Codegulasch/printdock-station/case/plate.stl

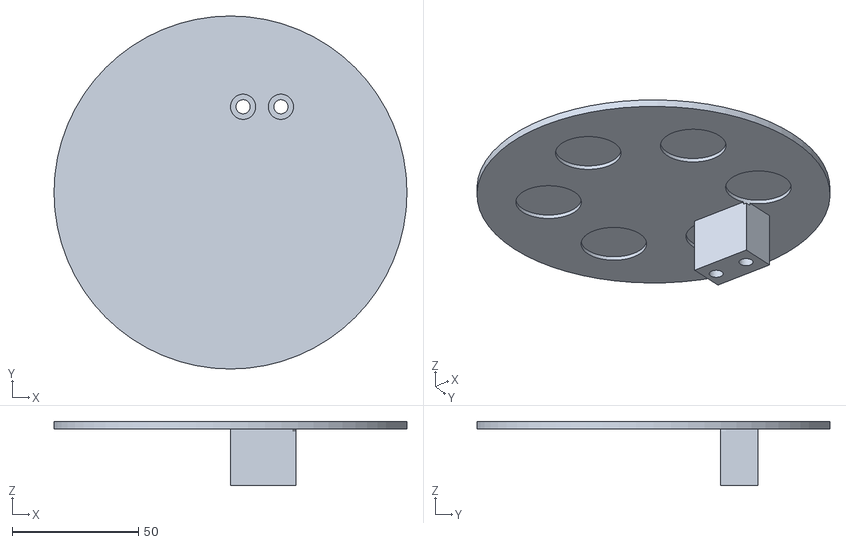
[picture p1: CAD file, 2026-10-11, last stored version]
case/plate.stl
140.0 x 140.0 x 25.5
