Codegulasch/printdock-station/case/base.stl

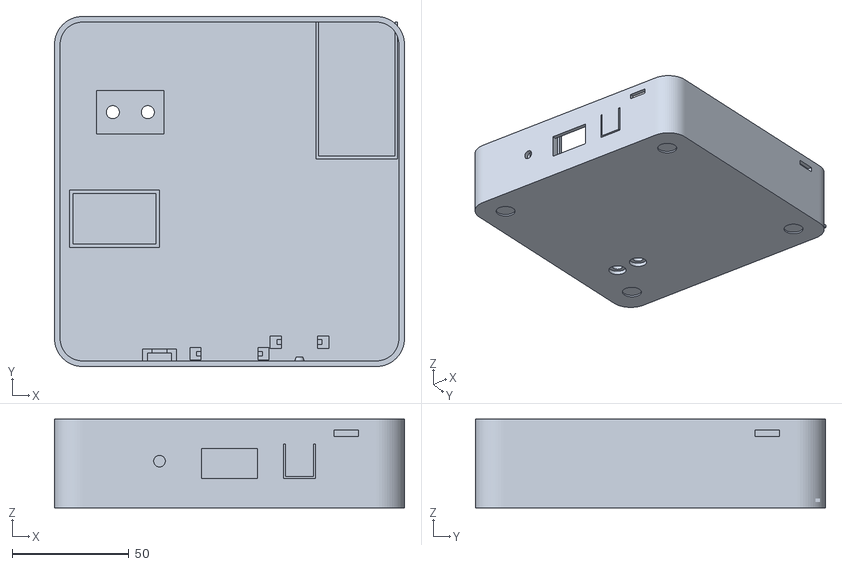
[picture p2: CAD file, 2026-10-11, last stored version]
case/base.stl
150.0 x 150.0 x 38.0
