Codegulasch/printdock-station/case/deck.stl

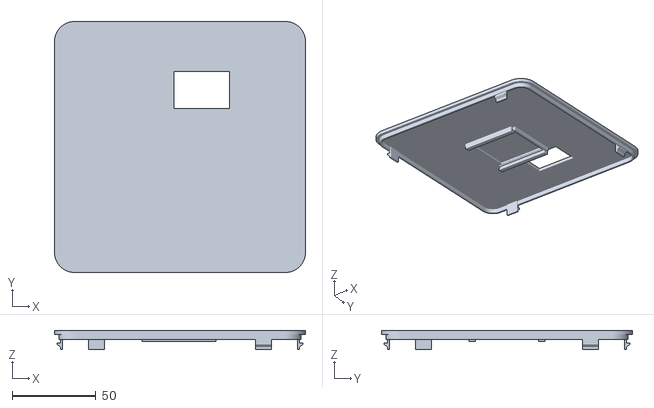
[picture p3: CAD file, 2026-10-11, last stored version]
case/deck.stl
150.0 x 150.0 x 11.4
