Codegulasch/printdock-station/docs/wiring.html

PrintDock Station · Firmware 0.3.1

# Verdrahtung der Station

Vier Pläne für dieselbe Station: D1 Mini (ESP8266) und ESP32-WROOM, jeweils auf dem Steckbrett und direkt verdrahtet. Die Pins folgen docs/wiring.md der Station-Firmware, die ESP32-Beschriftung einem DevKit mit 38 Pins (z. B. DIY MORE, USB-C).

Gehäuse und Waagen-Aufbau (Teller, Halterung der Wägezelle) sind noch in Arbeit – bis dahin auf einem Steckbrett oder einer Lochrasterplatine aufbauen.

D1 Mini

## Steckbrett

D1 Mini mit ESP8266 · Firmware printdock-station-d1_mini-0.3.1.factory.bin

3,3 V GND +− = beliebiges Loch der nächsten Schiene belegter Pin

Was | Loch | Pin
D1 Mini, Reihe 3V3 … RST | Spalte 1–8, Reihe i | Seite mit ESP-Modul oben, USB links
D1 Mini, Reihe 5V … TX | Spalte 1–8, Reihe b
Netzteil +5V | 1a | 5V
Netzteil GND | untere − Schiene
D1 GND | 2a → untere − Schiene
D1 3V3 | 1j → obere + Schiene
Brücken rechts | obere − ↔ untere −, obere + ↔ untere +
SDA-Kabel | 5a → 16a | D2
SCL-Kabel | 6a → 14a | D1
SCL weiter | 14d → 22d
SDA weiter | 16c → 24c
PN532 SCL / SDA | 14e / 16e
OLED SCL / SDA | 22e / 24e
HX711 DT / SCK | 5j / 4j | D5 / D6
Summer + | 2j | D8
KY-004 S | 4a | D3
LED (WS2812) DIN | 3j (über dem D1) | D7
LED 5V | an das Netzteil-Kabel +5V (Klemme/Lötstelle) | 5V
LED GND | obere − Schiene

- PN532 auf I²C: Schalter 1 ON, Schalter 2 OFF, die 4-polige Leiste nutzen.
- Taster an D3 ist der Flash-Pin: beim Einstecken nicht drücken. Zurücksetzen: erst einschalten, dann halten, sobald „jetzt Taste halten“ erscheint.
- Die I²C-Kabel stecken in der unteren Hälfte (a–e). Obere und untere Hälfte sind nicht verbunden.

D1 Mini

## Schaltplan

Direkt verdrahtet, ohne Steckbrett

3,3-V-Sammelleitung GND-Sammelleitung Punkt = Verbindung, Bogen = Kreuzung ohne Verbindung belegter Pin

Bauteil | Pin | D1 Mini
PN532 (I²C) | SDA / SCL | D2 / D1
PN532 | VCC / GND | 3V3 / G
OLED | SDA / SCL | D2 / D1
OLED | VCC / GND | 3V3 / G
HX711 | DT / SCK | D5 / D6
HX711 | VCC / GND | 3V3 / G
Wägezelle | rot / schwarz / weiß / grün | HX711 E+ / E− / A− / A+
KY-004 | S / Mitte / − | D3 / 3V3 / G
Summer (passiv) | + / − | D8 / G
Netzteil | +5V / GND | 5V / G
LED (WS2812) | DIN / 5V / GND | D7 / 5V / G

- PN532 und OLED teilen sich SDA und SCL: die Abzweige als Lötstelle oder mit einer kleinen Klemme verbinden.
- 3,3-V-Klemme: 5 Kabel (D1 3V3, PN532, OLED, HX711, KY-004 Mitte). GND-Klemme: 8 Kabel (D1 G, Netzteil, PN532, OLED, HX711, KY-004, Summer, LED).
- Die LED braucht 5 V, nicht 3,3 V: ihr 5V-Kabel mit dem +5V des Netzteils verbinden (Klemme mit 3 Kabeln: Netzteil, D1 5V, LED).

ESP32-WROOM

## Schaltplan

ESP32-DevKit 38 Pin (DIY MORE, USB-C) · Firmware printdock-station-esp32dev-….factory.bin

3,3-V-Sammelleitung GND-Sammelleitung Punkt = Verbindung, Bogen = Kreuzung ohne Verbindung belegter Pin

Bauteil | Pin | ESP32
PN532 (SPI) | MOSI / MISO / SCK / SS | G23 / G19 / G18 / G5
PN532 | VCC / GND | 3V3 / GND
OLED | SDA / SCL | G21 / G22
OLED | VCC / GND | 3V3 / GND
HX711 | DT / SCK | G32 / G33
HX711 | VCC / GND | 3V3 / GND
Wägezelle | rot / schwarz / weiß / grün | HX711 E+ / E− / A− / A+
KY-004 | S / Mitte / − | G27 / 3V3 / GND
Summer (passiv) | + / − | G25 / GND
Netzteil | +5V / GND | V5 / GND
LED (WS2812) | DIN / 5V / GND | G4 / V5 / GND

- PN532 auf SPI: Schalter 1 OFF, Schalter 2 ON, die 8-polige Leiste nutzen. Danach einmal ganz stromlos machen.
- 3V3 sitzt beim 38-Pin-DevKit links oben, GND rechts oben, V5 links unten. MOSI gehört an G23 (rechts, zweiter Pin von oben) – der Aufdruck sieht leicht wie „G33“ aus.
- 3,3-V-Klemme: 5 Kabel (ESP 3V3, HX711, KY-004 Mitte, OLED, PN532). GND-Klemme: 8 Kabel (ESP, Netzteil, HX711, Summer, KY-004, OLED, PN532, LED).
- Die LED braucht 5 V, nicht 3,3 V: ihr 5V-Kabel mit dem +5V des Netzteils verbinden (Klemme mit 3 Kabeln: Netzteil, ESP V5, LED).

ESP32-WROOM

## Steckbrett

ESP32 liegt neben dem Steckbrett, das Brett ist um 90° gedreht

3,3 V GND +− = beliebiges Loch der nächsten Schiene belegter Pin

ESP32 / Was | Loch | Modul
ESP GND (rechts oben) | linke − Schiene
ESP 3V3 (links oben) | über den ESP → linke + Schiene
G23 | 2a | Brücke 2d → 12d, PN532 MOSI in 12e
G22 | 3a | OLED SCL in 3e
G21 | 6a | OLED SDA in 6e
G19 | 8a | PN532 MISO in 8e
G18 | 9a | PN532 SCK in 9e
G5 | 10a | PN532 SS in 10e
G4 | 13a | LED (WS2812) DIN in 13e
V5 | 22a | Netzteil +5V in 22e, LED 5V in 22d
G27 | 24a | KY-004 S in 24e
G25 | 26a | Summer + in 26e
G33 | 28a | HX711 SCK in 28e
G32 | 30a | HX711 DT in 30e
Schienen | links − ↔ rechts −, links + ↔ rechts + | unten am Brett
Modul-Versorgung | rechte + / − Schiene | VCC, Mitte (KY-004) an +, alle GND und − an −

- Kabel vom ESP32 zum Brett: Buchse–Stecker (female–male). Die Buchse kommt auf den ESP-Pin.
- Das Brett ist gedreht: Spalte 1 oben, Spalte 30 unten, Reihen a–j von links nach rechts. Die Pins auf der rechten ESP-Seite liegen genau gegenüber ihrer Spalte.
- Jede Spalte verbindet nur a–e. Deshalb steckt das ESP-Kabel in a und das Modul-Kabel in e derselben Spalte.

Alle Module laufen mit 3,3 V, nur das Netzteil hängt an 5V bzw. V5. Netzteil und USB nicht gleichzeitig anstecken. Zeigt die Waage negative Werte, A+ und A− am HX711 tauschen.
