Codegulasch/printdock-station/(commit log)

2026-10-11 Add ESP32 PrintDock Station firmware
    Introduce firmware for NFC tag reading and writing, scale measurement, OLED status, Wi-Fi setup, and WebSocket pairing with PrintDock. Add protocol and wiring documentation, PlatformIO builds for two ESP32 boards, and factory image generation.
2026-10-11 Add optional humidity sensor support
    Detect supported I²C humidity sensors, report temperature and humidity to PrintDock every 30 seconds, and display readings on the OLED. The station can now operate as a standalone humidity monitor without NFC or a scale.
2026-10-11 Document PrintDock Sensor setup
    Update the English and German READMEs and wiring guide to name the humidity-only configuration the PrintDock Sensor and explain where to find and pair it in PrintDock.
2026-10-11 Update PrintDock settings navigation docs
    Refresh the English and German setup, protocol, and wiring guides with the current menu paths for station pairing and humidity sensors.
2026-10-11 Add ESP8266 D1 Mini support
    Add a PlatformIO target for the D1 Mini ESP8266, including its I²C PN532 setup, board-specific pins and firmware handling. Document wiring and build instructions.
2026-10-11 Add printable station case and assembly guide
    Add STL files and a parametric OpenSCAD model for a support-free PrintDock Station case, plus German assembly and customization instructions. Link the case from both READMEs and mention it in the changelog.
    [base.stl, deck.stl, plate.stl, printdock-station-case.scad]
2026-10-14 Monitor and recover the NFC reader
    Check PN532 responsiveness, automatically reinitialize it after failures, and report reader status changes to the display and PrintDock. Recover a blocked I2C bus at startup and document NFC troubleshooting.
    [config.h, main.cpp, nfc.cpp, nfc.h, ui.cpp]
2026-10-14 Add wiring diagrams for ESP32 and D1 Mini
    Document schematic and breadboard wiring for both boards, with a standalone HTML guide and updated README and changelog links.
2026-10-17 Update README to remove case reference
    Removed mention of the printable case from the parts cost section.
2026-10-18 Document beta setup and WS2812 wiring
    Expand the English and German READMEs with beta status, build and setup instructions, daily use, and troubleshooting. Add WS2812 power and pin connections to the wiring diagrams and documentation, and clarify that the enclosure and scale assembly are still in development.
